cakraawijaya/Aquaponic-pH-Control-Monitoring-with-Type-2-Fuzzy-Method-Based-on-IoT-Bot/README.md

# Aquaponic pH Control-Monitoring with Type 2 Fuzzy Method-Based on IoT-Bot
<strong>Undergraduate Thesis Project Documentation - Informatics UPN Veteran Jatim</strong><br><br>
An aquaponic system is a combined farming system between fish with vegetables where the activities are mutually beneficial. On the other hand, crop failure can also be a concern for aquaponic farmers as this can happen at any time. Harvest failure can be influenced by many factors, but is usually caused by the high pH ambiguity of the water around the scope of cultivation. The aquaponic farmers are worried that if the crop failure continues it will harm their food security. This project was created in the hope of solving the pH problem. This project has been carried out and took approximately 1 year. The system created can control and monitor changes in water pH at any time. This system is based on the Internet of Things (IoT), using MQTT as the communication protocol. This system is also equipped with artificial intelligence, which uses IT2FL (Interval Type-2 Fuzzy Logic) as its decision support. In addition, the system interface uses Telegram Bot, making it easier for users to interact.

<br><br>

## Project Requirements
| Part | Description |
| --- | --- |
| Development Board | DOIT ESP32 DEVKIT V1 |
| Supporting Board | Arduino Uno R3 |
| Code Editor | Arduino IDE 1.8.19 (Stable Legacy Version) |
| Application Support | • Telegram Bot<br>• Matlab R2020 |
| Driver | CP210X USB Driver |
| IoT Platform | io-t.net |
| Communications Protocol | • Inter Integrated Circuit (I2C)<br>• Message Queuing Telemetry Transport (MQTT)<br>• MTProto |
| IoT Architecture | 3 Layer |
| Matlab |  Fuzzy Interface System |
| Programming Language | C/C++ |
| Arduino Library | • WiFi (default)<br>• PubSubClient by Nick O'Leary (Version: 2.8)<br>• LiquidCrystal_I2C by Frank de Brabander (Version: 1.1.2)<br>• CTBot by Stefano Ledda (Version: 2.1.11)<br>• ArduinoJson by Benoit Blanchon (Version: 6.19.4)<br>• RTClib by Adafruit (Version: 2.0.2) |
| Actuators | • Submersible pump aquarium (x1)<br>• Pneumatic solenoid valve (x2)<br>• Piezoelectric (x1)<br>• Electromechanical relay 2-channel (x1) |
| Sensor | • pH Sensor (x1)<br>• RTC (x1) |
| Display | LCD I2C (x1) |
| Experimental Object | • Pakcoy mustard seeds<br>• Dumbo catfish fry |
| Other Components | • Micro USB cable - USB type A (x1)<br>• Jumper cable (1 set)<br>• Switching power supply 12V 1A (x1)<br>• Round switch (x1)<br>• DOIT ESP32 DEVKIT V1 expansion board (x1)<br>• PCB Dot Matrix (x1)<br>• Terminal PCB block screw (x10)<br>• Socket female jack DC (x1)<br>• Connector male jack DC (x3)<br>• Probe Elektroda pH (x1)<br>• Pipes (1 set)<br>• Netpot (1 set)<br>• Rockwool (1 set)<br>• Flannel fabric (1 set)<br>• Water filter (x1)<br>• Glass hubcap (1 set)<br>• Bottle (x2)<br>• Aquarium wheeled placemat (x1)<br>• Aquarium (x1)<br>• Acrylic box (x1)<br>• Solenoid Valve Plastic Cover (x2)<br>• Skun (1 set)<br>• Galvanized plate (x1)<br>• Bolts plus (1 set)<br>• Nuts (1 set) |

<br><br>

## Download & Install 
1. Arduino IDE

   <table><tr><td width="810">

   ```
   https://www.arduino.cc/en/software
   ```

   </td></tr></table><br>

2. CP210X USB Driver

   <table><tr><td width="810">

   ```
   https://bit.ly/CP210X_USBdriver
   ```

   </td></tr></table><br>

3. Matlab R2020

   <table><tr><td width="810">

   ```
   https://bit.ly/MATLAB_R2020a_Installer
   ```

   </td></tr></table>

<br><br>

## Project Designs
<table>
<tr>
<th width="840">Infrastructure</th>
</tr>
<tr>
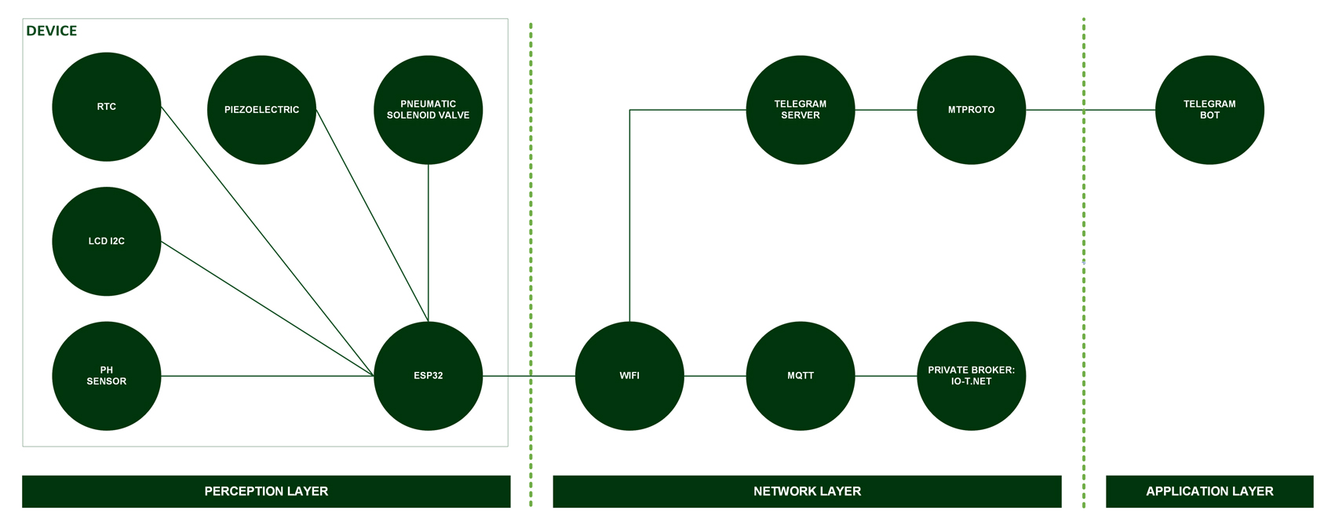
[picture p1: Assets/Documentation/Diagram/Infrastructure.jpg]
infrastructure
<td></td>
</tr>
</table>
<table>
<tr>
<th width="280">Pictorial Diagram</th>
<th width="280">Prototype Design</th>
<th width="280">Main Box Design</th>
</tr>
<tr>
<td>pictorial-diagram</td>
<td>prototype-design</td>
<td>mainBox-design</td>
</tr>
</table>
<table>
<tr>
<th width="280">Fuzzy Interface System IT2FL</th>
<th width="280">IT2FL Input Variable</th>
<th width="280">IT2FL Output Variable</th>
</tr>
<tr>
<td>fis-it2fl</td>
<td>varin-it2fl</td>
<td>varout-it2fl</td>
</tr>
</table>

<br><br>

## Scanning the I2C Address on the LCD
<table><tr><td width="840">
   
```ino
/*
  =====================================================
  I2C Scanner for Arduino / ESP32 / ESP8266
  by: Devan Cakra Mudra Wijaya, S.Kom.
  =====================================================

  Functions:
  - Detects all connected I2C devices
  - Displays device addresses in HEX format
  - Displays the total number of detected devices

  =====================================================
  SDA and SCL Pins for Arduino / ESP32 / ESP8266
  =====================================================
  Arduino I2C Connection (default):
  - Arduino Uno / Nano (ATmega328P)
    SDA -> A4
    SCL -> A5

  - Arduino Mega 2560
    SDA -> D20
    SCL -> D21

  - Other Arduino boards
    SDA -> SDA pin
    SCL -> SCL pin
    (Refer to the datasheet or board pinout)

  ESP32 I2C Connection (default):
  SDA -> GPIO 21
  SCL -> GPIO 22

  ESP8266 I2C Connection (default):
  SDA -> GPIO 4 (D2)
  SCL -> GPIO 5 (D1)
*/

// Include the Wire library for I2C communication
#include <Wire.h>

// Constant that defines the delay between scans (5000 ms = 5 seconds)
const uint32_t SCAN_INTERVAL = 5000;

// Function to initialize I2C communication
// SDA and SCL pin configuration will be adjusted automatically based on the board being used
void initI2C() {

  // If the board being used is ESP32:
  #if defined(ESP32)

    // Enable I2C communication
    // SDA = GPIO21
    // SCL = GPIO22
    Wire.begin(21, 22);

  // If the board being used is ESP8266:
  #elif defined(ESP8266)

    // Enable I2C communication
    // SDA = D2 (GPIO4)
    // SCL = D1 (GPIO5)
    Wire.begin(D2, D1);

  // If the board is neither ESP32 nor ESP8266
  // Examples: Arduino Uno, Nano, Mega, Leonardo, etc.
  #else

    // Enable I2C communication using the board's built-in hardware pins
    Wire.begin();

  #endif

}

// The setup() function runs once when the board is powered on or reset
// It is used to initialize hardware, serial communication, sensors, modules, and the program's initial configuration
void setup() {

  // Start Serial communication at 115200 baud rate
  Serial.begin(115200);

  // Check whether the board uses native USB
  // Examples: Arduino Leonardo, Arduino Micro, some ESP32-S2/S3 boards
  #if defined(USBCON) || defined(ARDUINO_USB_CDC_ON_BOOT)

    // If yes:
    // The program will wait until the Serial Monitor is connected before continuing execution
    while (!Serial);

  #endif

  // Wait for 2 seconds before starting the program
  delay(2000);

  // Display program header
  Serial.println("====================================");
  Serial.println("         I2C DEVICE SCANNER         ");
  Serial.println("by: Devan Cakra Mudra Wijaya, S.Kom.");
  Serial.println("====================================");

  // Print an empty line
  Serial.println();

  // Initialize I2C communication
  initI2C();
}

// The loop() function runs continuously after setup() has finished
// The main program logic is typically placed inside this function
void loop() {

  // Variable to store the error code returned from I2C communication
  uint8_t error;

  // Variable to store the I2C address currently being checked
  uint8_t address;

  // Counter variable for the number of detected devices
  uint8_t deviceCount = 0;

  // Display information indicating that the scan process has started
  Serial.println("------------------------------------");
  Serial.println("Scanning I2C bus...");
  Serial.println("------------------------------------");

  // Loop through addresses from 1 to 126
  // Valid I2C addresses range from 0x01 to 0x7E
  for (address = 1; address < 127; address++) {

    // Start communication with the address currently being tested
    Wire.beginTransmission(address);

    // End the transmission and store the result
    // 0 = success
    // 1 = data too long
    // 2 = NACK received when address was sent
    // 3 = NACK received when data was sent
    // 4 = other error
    error = Wire.endTransmission();

    // If no error occurs:
    if (error == 0) {

      // Display information that a device was found
      Serial.print("[FOUND] Device at address 0x");

      // If the address is less than 16:
      // Add a leading zero to keep HEX formatting aligned
      if (address < 16) {
        Serial.print("0");
      }

      // Display the address in HEX format
      Serial.println(address, HEX);

      // Increment the detected device count
      deviceCount++;
    }

    // If an unknown error occurs:
    else if (error == 4) {

      // Display an error message
      Serial.print("[ERROR] Unknown error at address 0x");

      // If the address is less than 16:
      // Add a leading zero to keep HEX formatting aligned
      if (address < 16) {
        Serial.print("0");
      }

      // Display the problematic address in HEX format
      Serial.println(address, HEX);
    }

    // If the error is neither 0 nor 4:
    // Ignore it, as this usually means no device exists at that address
  }

  // Print an empty line
  Serial.println();

  // If no devices were found:
  if (deviceCount == 0) {

    // Display a message indicating that no devices were found
    Serial.println("No I2C devices found.");
  }
  else { // If at least one device was found:

    // Display the total number of detected devices
    Serial.print("Total devices found: ");

    // Display the value of deviceCount
    Serial.println(deviceCount);
  }

  // Display information about the next scan
  Serial.print("Next scan in ");

  // Convert milliseconds to seconds
  Serial.print(SCAN_INTERVAL / 1000);

  // Display the unit in seconds
  Serial.println(" seconds.");

  // Empty line
  Serial.println("\n");

  // Wait 5 seconds before performing the next scan
  delay(SCAN_INTERVAL);
}
```

</td></tr></table><br><br>

##  pH Sensor Calibration
The pH sensor can be calibrated using the results of a linear regression calculation. You can see the linear regression equation as follows.

<table>
   <tr>
   <td width="40">I</td>
   <td width="800" height="80">

   $\ Y = a+b.X $
         
   </td>      
   </tr>
</table><br>

Explanation of the symbols in equation I, you can see more details in the following table.

<table>
   <tr height="50px">
      <th width="120">Symbol</th>
      <th width="720">Description</th>
   </tr>
   <tr>
      <td>𝑌</td>
      <td>pH buffer value</td>
   </tr>
   <tr>
      <td>𝑋</td>
      <td>voltage value obtained based on Y</td>
   </tr>
   <tr>
      <td>𝑎 and 𝑏</td>
      <td>linear regression determination value</td>
   </tr>
</table><br>

The linear regression determination values (a and b) can be obtained through equations II and III.

<table>
   <tr>
   <td width="40">II</td>
   <td width="800" height="80">
   
   $\ a = \frac{\sum Y.\sum X^{2}-\sum X.\sum XY}{n.\sum X^{2}-(\sum X)^{2}} $

   </td>
   </tr>
   <tr>
   <td width="40">III</td>
   <td width="800" height="80">
   
   $\ b = \frac{n.\sum XY-\sum X.\sum Y}{n.\sum X^{2}-(\sum X)^{2}} $

   </td>
   </tr>
</table><br>

Example of pH sensor calibration: <a href="https://github.com/devancakra/Aquaponic-pH-Control-Monitoring-with-Type-2-Fuzzy-Method-Based-on-IoT-Bot/blob/master/Assets/Articles/pHSensor-Calibration-Example.md">Click Here</a>

<br><br>

## RTC Sensor Calibration
This RTC sensor can be calibrated using the following program code :
   
<table><tr><td width="840">

```ino
#include <RTClib.h> // Calling the RTC library
RTC_DS3231 rtc; // Constructor

void setup() {
   RTCinit(); // Calling the RTCinit method
}

void loop() {}

void RTCinit() {
   // Starting up the RTC
   rtc.begin();

   // Set Time Now
   // If calibrated, please close with a comment
   rtc.adjust(DateTime(YYYY, MM, DD, HH, MM, SS));
}
```

</td></tr></table><br><br>

## Arduino IDE Setup
1. Open the ``` Arduino IDE ``` first, then open the project by clicking ``` File ``` -> ``` Open ``` : 

   <table><tr><td width="810">
   
      ``` PH_IT2FL.ino ```

   </td></tr></table><br>
   
2. Fill in the ``` Additional Board Manager URLs ``` in Arduino IDE

   <table><tr><td width="810">
      
      Click ``` File ``` -> ``` Preferences ``` -> enter the ``` Boards Manager Url ``` by copying the following link :
      
      ```
      https://dl.espressif.com/dl/package_esp32_index.json
      ```

   </td></tr></table><br>
   
3. ``` Board Setup ``` in Arduino IDE

   <table>
      <tr><th width="810">

      How to setup the ``` DOIT ESP32 DEVKIT V1 ``` board
            
      </th></tr>
      <tr><td width="810">
      
      • Click ``` Tools ``` -> ``` Board ``` -> ``` Boards Manager ``` -> Install ``` esp32 ```. 
      
      • Then selecting a Board by clicking: ``` Tools ``` -> ``` Board ``` -> ``` ESP32 Arduino ``` -> ``` DOIT ESP32 DEVKIT V1 ```.

      • ``` Arduino Uno ``` board in this project is only used as a filter or voltage divider.

      • You don't need to configure the ``` Arduino Uno ``` board, just focus on the ``` ESP32 ```.

   </td></tr></table><br>
   
4. ``` Change the Board Speed ``` in Arduino IDE

   <table><tr><td width="810">
      
      Click ``` Tools ``` -> ``` Upload Speed ``` -> ``` 9600 ```

   </td></tr></table><br>
   
5. ``` Install Library ``` in Arduino IDE

   <table><tr><td width="810">
      
      Download all the library zip files. Then paste it in the: ``` C:\Users\Computer_Username\Documents\Arduino\libraries ```

   </td></tr></table><br>

6. ``` Port Setup ``` in Arduino IDE

   <table><tr><td width="810">
      
      Click ``` Port ``` -> Choose according to your device port ``` (you can see in device manager) ```

   </td></tr></table><br>

7. Change the ``` WiFi Name ```, ``` WiFi Password ```, and so on according to what you are currently using.<br><br>

8. Before uploading the program, please click: ``` Verify ```.<br><br>

9. If there is no error in the program code, then please click: ``` Upload ```.<br><br>
    
10. Some things you need to do when using the ``` ESP32 board ``` :

    <table><tr><td width="810">
       
       • If ``` ESP32 board ``` cannot process ``` Source Code ``` totally -> Press ``` EN (RST) ``` button -> ``` Restart ```.

       • If ``` ESP32 board ``` cannot process ``` Source Code ``` automatically then :<br>

      - When information: ``` Uploading... ``` has appeared -> immediately press and hold the ``` BOOT ``` button.<br>

      - When information: ``` Writing at .... (%) ``` has appeared -> release the ``` BOOT ``` button.

      • If message: ``` Done Uploading ``` has appeared -> ``` The previously entered program can already be operated ```.

      • Do not press the ``` BOOT ``` and ``` EN ``` buttons at the same time as this may switch to ``` Upload Firmware ``` mode.

    </td></tr></table><br>

11. If there is still a problem when uploading the program, then try checking the ``` driver ``` / ``` port ``` / ``` others ``` section.

<br><br>

## Io-t.net Setup
1. Getting started with io-t.net :

   <table><tr><td width="810">
      
      • Go to the official website at the following link : <a href="https://io-t.net/">io-t.net</a>.
      
      • If you do not have an account, please <a href="https://i-ot.net/register">Register</a> first -> activate your account via email.
      
      • If you already have an account, please <a href="https://i-ot.net/login">Sign In</a> to be able to access io-t.net services.

   </td></tr></table><br>

2. Create a node :

   <table><tr><td width="810">
      
      • Go to ``` Instance ``` menu -> ``` Set Node ```.
      
      • Then give the node a unique name that you use.

   </td></tr></table><br>

3. Create a device :

   <table><tr><td width="810">
      
      • Go to ``` Devices ``` menu.
      
      • Select ``` Add Devices ``` -> fill in the ``` Client ID ```, ``` Access ```, ``` Topic ``` sections as needed. For example :
   
      - ``` Client ID ``` -> ``` Phiotnet_v1 ```.

      - ``` Access ``` -> ``` Publish & Subscribe ```.

      - ``` Topic ``` -> ``` detect ```.

   </td></tr></table>
   
<br><br>

## Telegram Bot Setup
1. Open <a href="https://t.me/botfather">@BotFather</a>.<br><br>

2. Type ``` /newbot ```.<br><br>

3. Type the desired bot name, for example: ``` phiotnet_bot ```.<br><br>

4. Type the desired bot username, for example: ``` phiotnet_bot ```.<br><br>

5. Also do it for bot image settings, bot descriptions, and so on according to your needs.<br><br>

6. Copy ``` your telegram bot API token ``` -> then paste it into the ``` #define BOTtoken "YOUR_API_BOT_TOKEN" ``` section. 

   <table><tr><td width="810">
   For example :<br><br>

   ```ino
   #define BOTtoken "2006772150:AAE6Fdjk3KbiySkzV6CLbd6ClJDzgTfJ5y0"
   ```
   
   </td></tr></table>

<br><br>

## Matlab Setup
1. Open the ``` Matlab ```.<br><br>

2. Open the ``` Set Path ``` dialog box using the command :
   
   <table><tr><td width="810">
      
   ```
   pathtool
   ```

   </td></tr></table>
   
   set-path-matlab<br><br>

3. Select ``` Add Folder... ``` -> search the ``` FIS-IT2FLS-Toolbox-MATLAB ``` folder -> ``` Select Folder ```.<br><br>

4. Click ``` Save ``` and then click ``` Close ```.<br><br>

5. Open the ``` IT2FL Toolbox ``` using the command :
   
   <table><tr><td width="810">

   ```
   fuzzyt2
   ```

   </td></tr></table>
   
   it2fl-toolbox<br><br>

6. The rest you can customize according to your needs.

<br><br>

## Get Started
1. Download and extract this repository.<br><br>
   
2. Make sure you have the necessary electronic components.<br><br>
   
3. Make sure your components are designed according to the diagram.<br><br>
   
4. Configure your device according to the settings above.<br><br>

5. Please enjoy [Done].

<br><br>

## Demonstration of Application
Via Telegram: <a href="https://t.me/phiotnet_bot">@phiotnet_bot</a>

<br><br>

## Highlights
<table>
<tr>
<th width="840">Product</th>
</tr>
<tr>
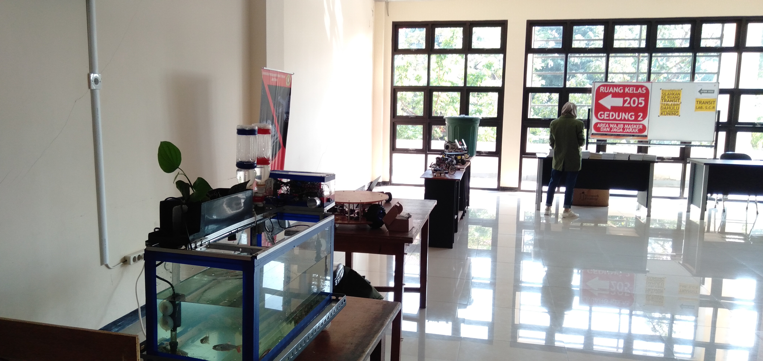
[picture p2: Assets/Documentation/Experiment/Product/Exhibition.jpg]
exhibition
<td></td>
</tr>
<tr>
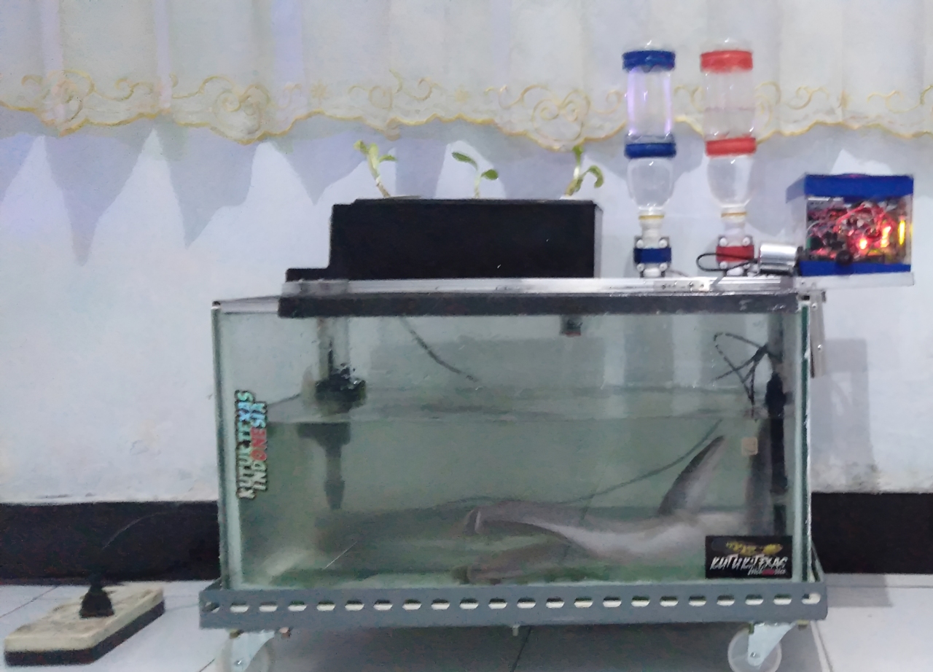
[picture p3: Assets/Documentation/Experiment/Product/Device ON.jpg]
device-on
<td></td>
</tr>
</table>
<table>
<tr>
<th width="840" colspan="6">LCD Screen</th>
</tr>
<tr>
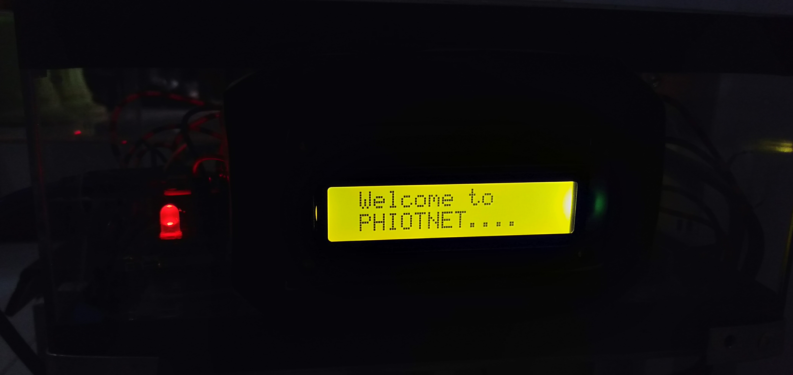
[picture p4: Assets/Documentation/Experiment/LCD/Welcome to PHIOTNET.jpg]
welcome-to-phiotnet
<td></td>
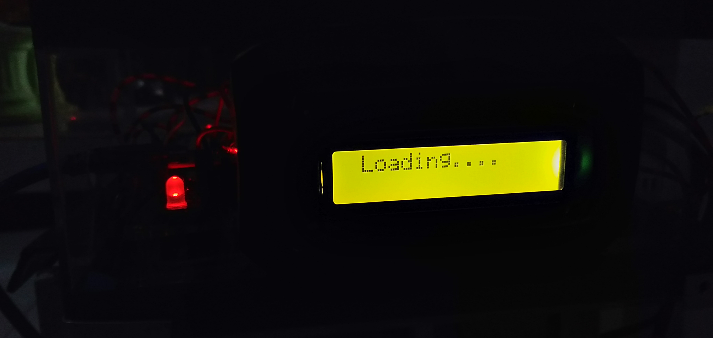
[picture p5: Assets/Documentation/Experiment/LCD/Loading.jpg]
loading
<td></td>
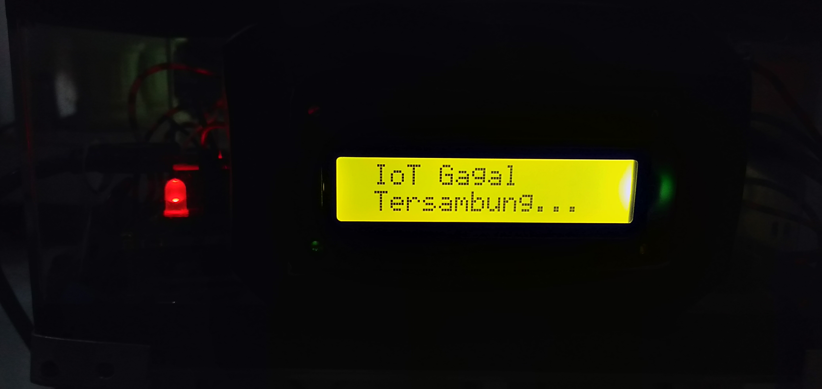
[picture p6: Assets/Documentation/Experiment/LCD/IoT Connection Failed.jpg]
iot-connection-failed
<td></td>
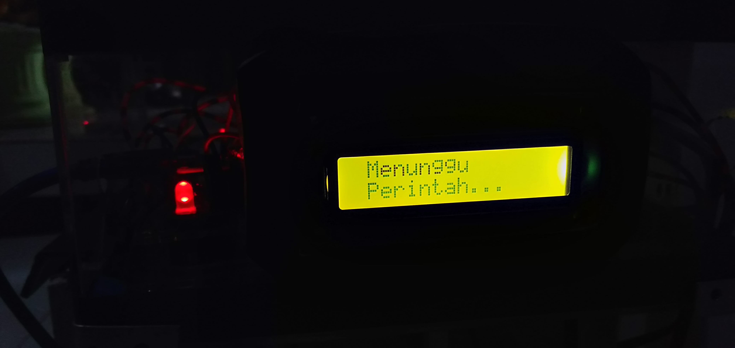
[picture p7: Assets/Documentation/Experiment/LCD/Waiting for Instructions.jpg]
waiting-for-instructions
<td></td>
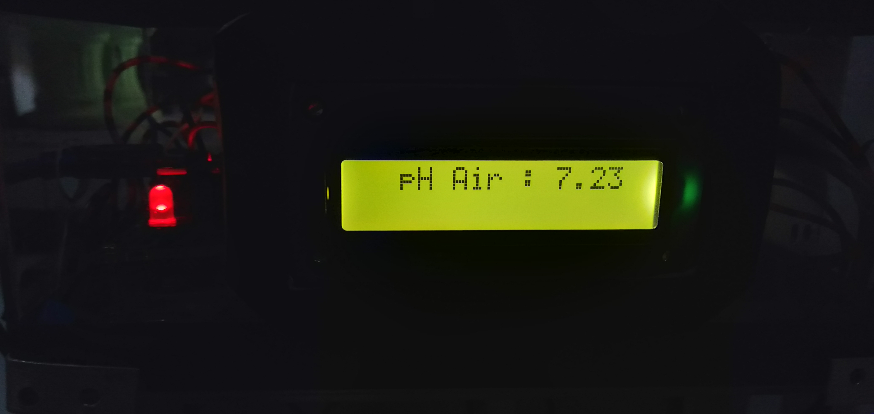
[picture p8: Assets/Documentation/Experiment/LCD/pH Value of Water.jpg]
ph-value-of-water
<td></td>
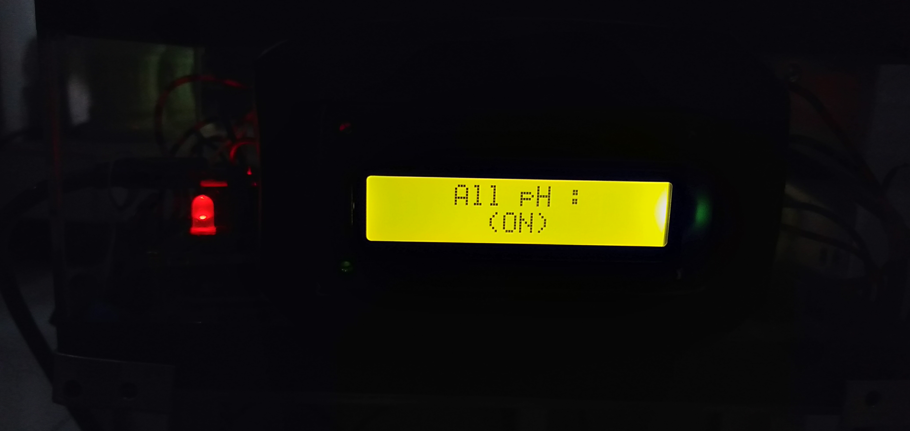
[picture p9: Assets/Documentation/Experiment/LCD/All pH ON.jpg]
all-pH-on
<td></td>
</tr>
<tr>
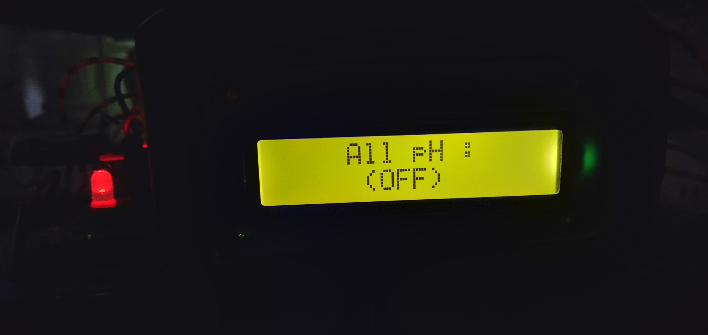
[picture p10: Assets/Documentation/Experiment/LCD/All pH OFF.jpg]
all-pH-off
<td></td>
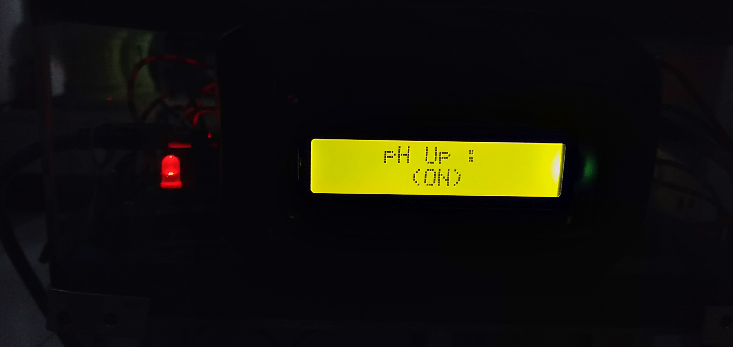
[picture p11: Assets/Documentation/Experiment/LCD/pH Up ON.jpg]
pH-up-on
<td></td>
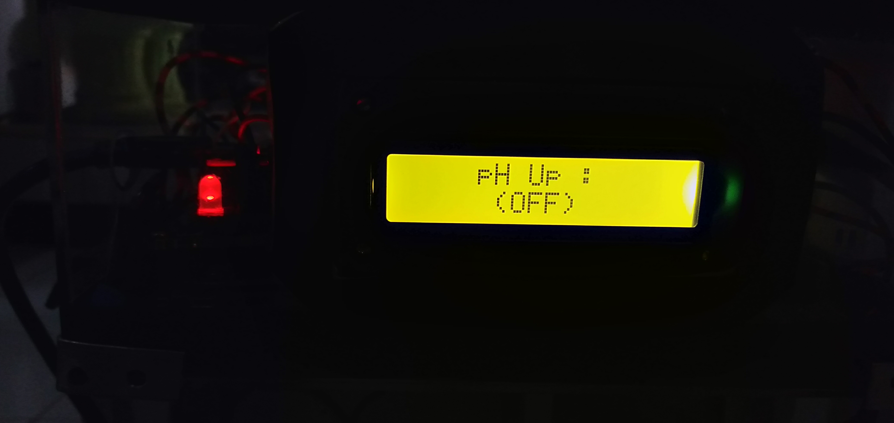
[picture p12: Assets/Documentation/Experiment/LCD/pH Up OFF.jpg]
pH-up-off
<td></td>
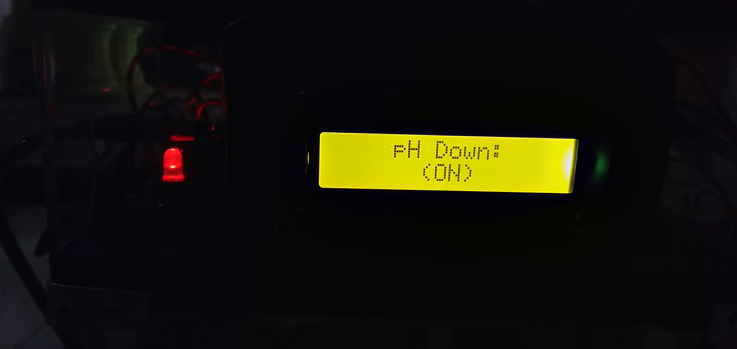
[picture p13: Assets/Documentation/Experiment/LCD/pH Down ON.jpg]
pH-down-on
<td></td>
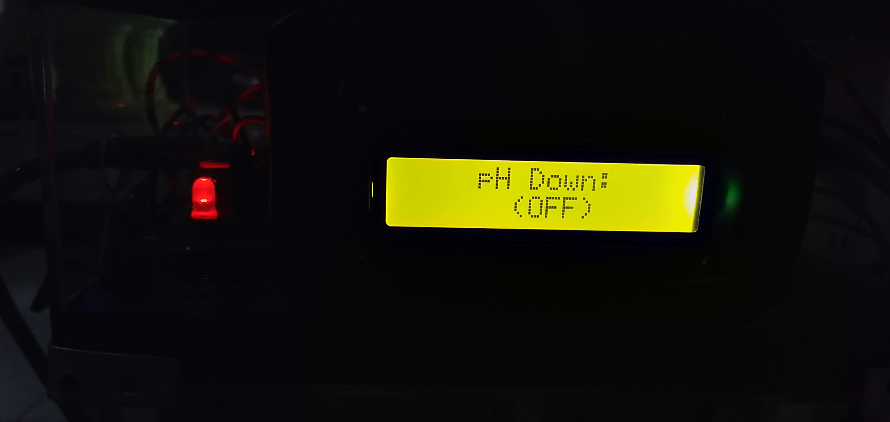
[picture p14: Assets/Documentation/Experiment/LCD/pH Down OFF.jpg]
pH-down-off
<td></td>
</tr>
</table>
<table>
<tr>
<th width="840" colspan="5">IT2FL Decision Support System</th>
</tr>
<tr>
<th width="168">Strong Acids</th>
<th width="168">Weak Acids</th>
<th width="168">Neutral</th>
<th width="168">Weak Bases</th>
<th width="168">Strong Bases</th>
</tr>
<tr>
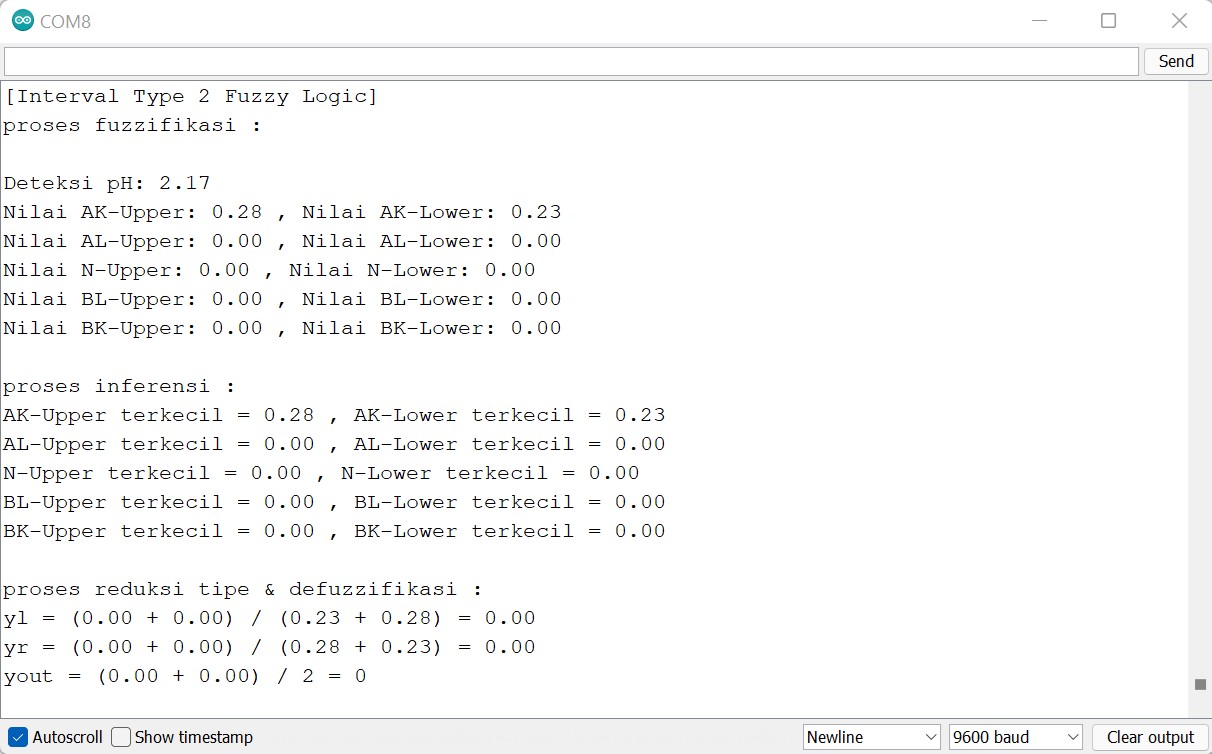
[picture p15: Assets/Documentation/Experiment/Serial Monitor/IT2FL Decision Support System/Strong Acids.jpg]
strong-acids
<td align="center"></td>
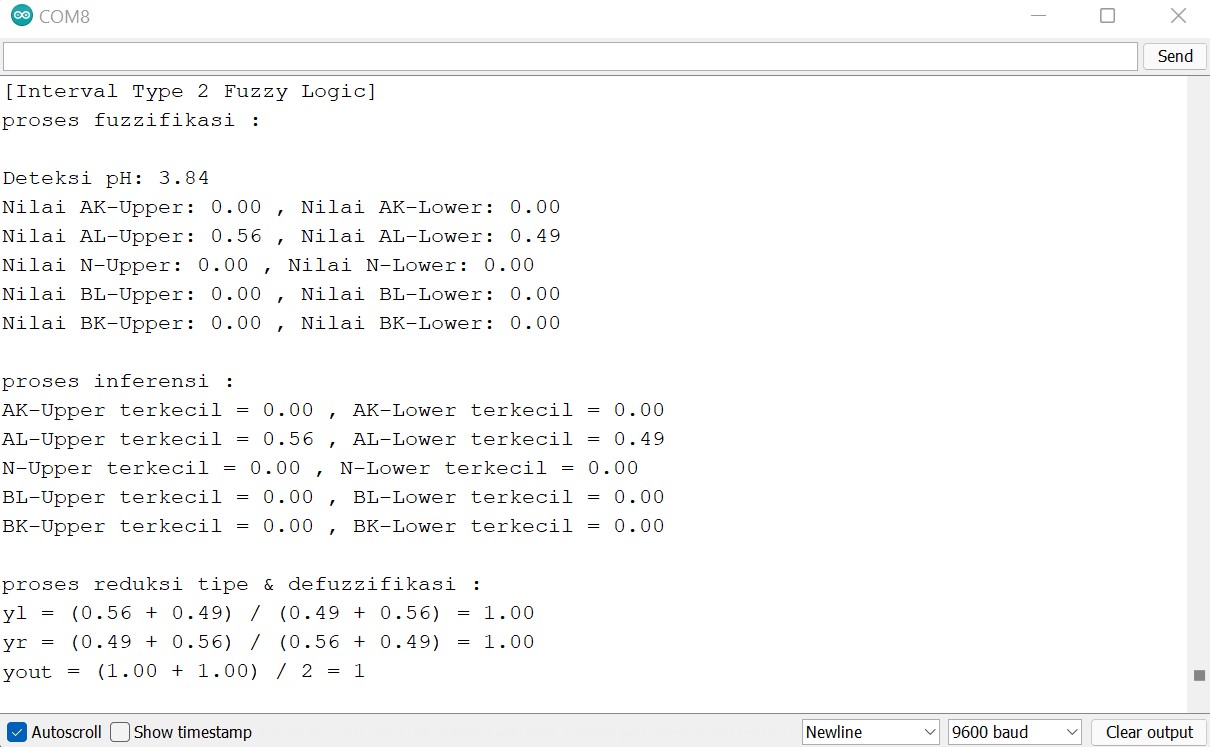
[picture p16: Assets/Documentation/Experiment/Serial Monitor/IT2FL Decision Support System/Weak Acids.jpg]
weak-acids
<td align="center"></td>
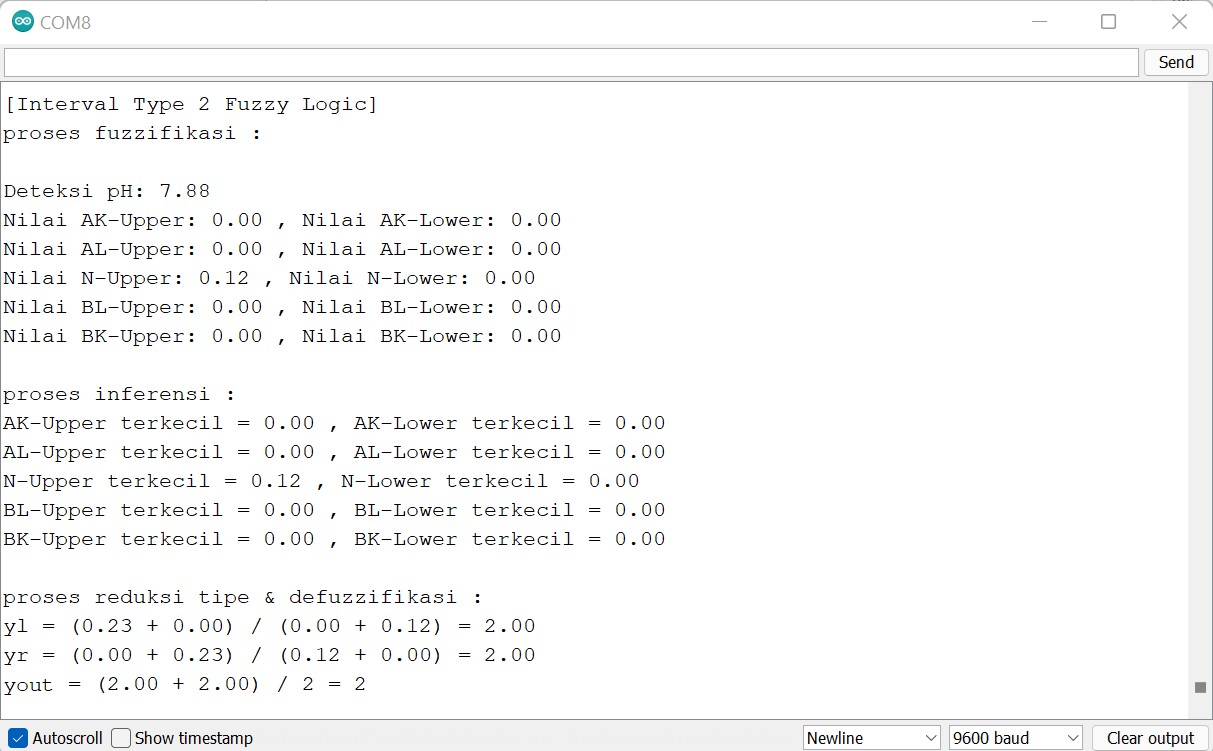
[picture p17: Assets/Documentation/Experiment/Serial Monitor/IT2FL Decision Support System/Neutral.jpg]
neutral
<td align="center"></td>
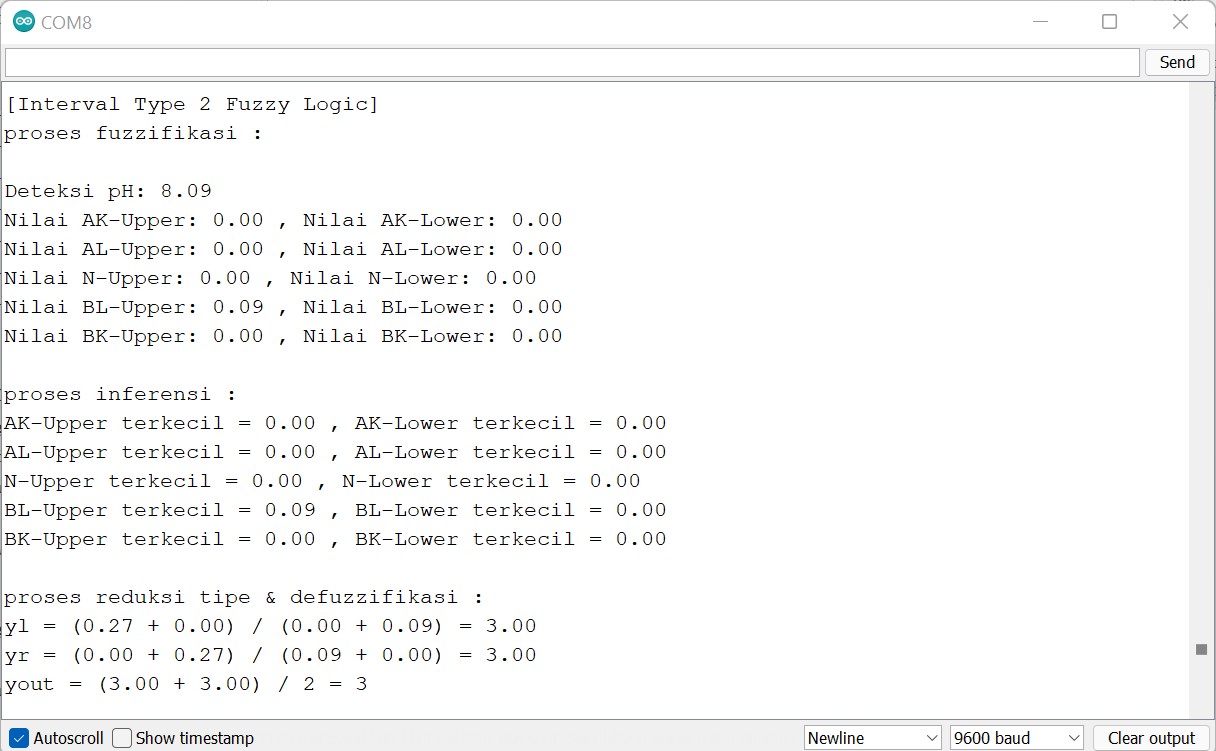
[picture p18: Assets/Documentation/Experiment/Serial Monitor/IT2FL Decision Support System/Weak Bases.jpg]
weak-bases
<td align="center"></td>
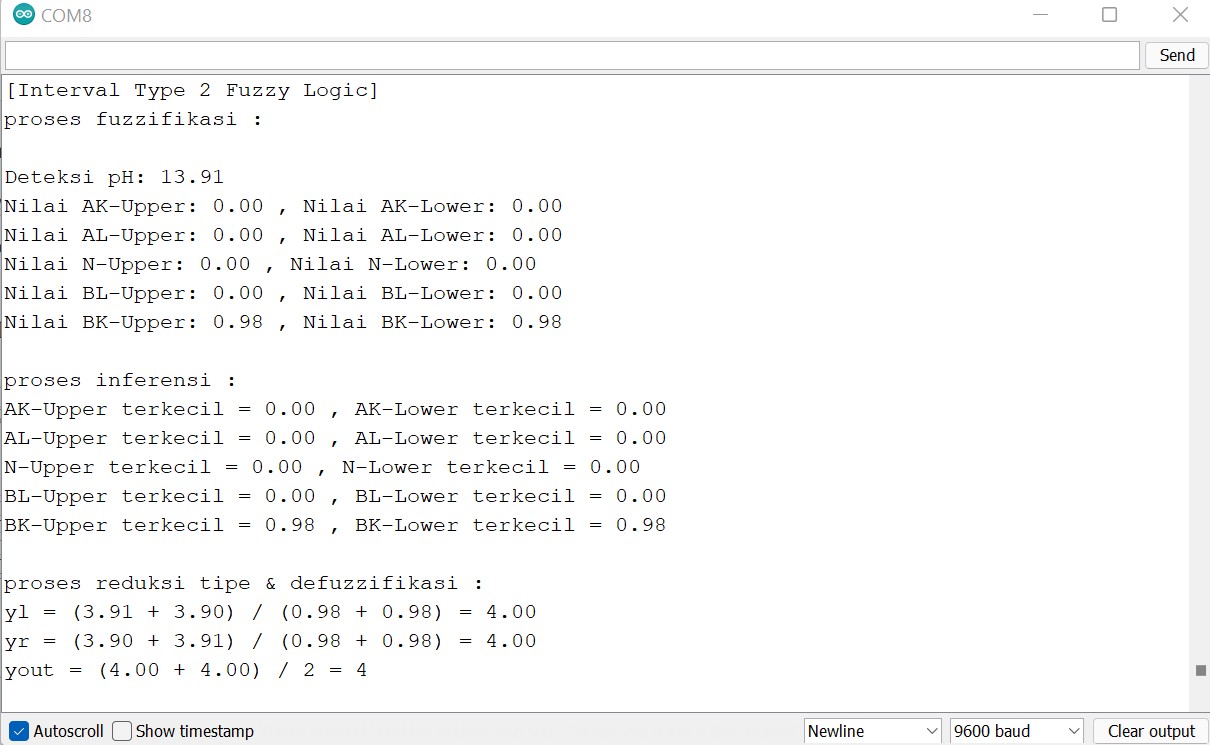
[picture p19: Assets/Documentation/Experiment/Serial Monitor/IT2FL Decision Support System/Strong Bases.jpg]
strong-bases
<td align="center"></td>
</table>
<table>
<tr>
<th width="840" colspan="6">Telegram Bot</th>
</tr>
<tr>
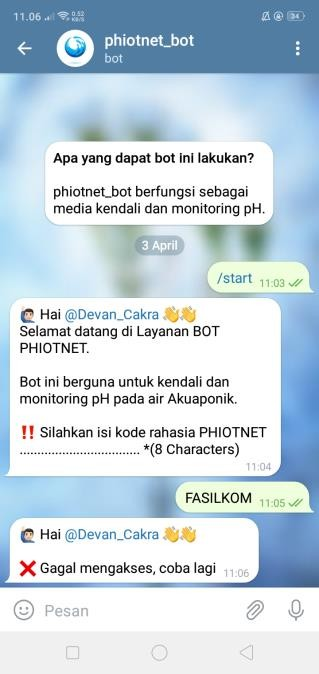
[picture p20: Assets/Documentation/Experiment/Telegram Bot/Access Denied.jpg]
access-denied
<td align="center"></td>
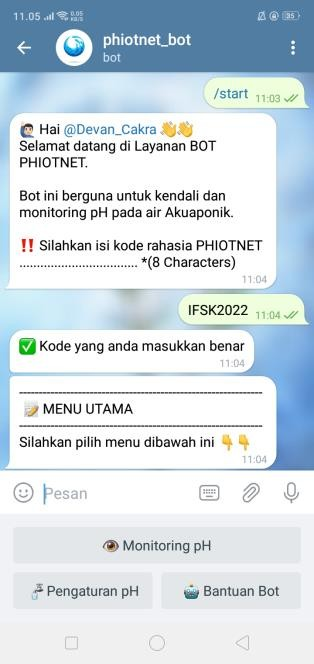
[picture p21: Assets/Documentation/Experiment/Telegram Bot/Main Menu.jpg]
main-menu
<td align="center"></td>
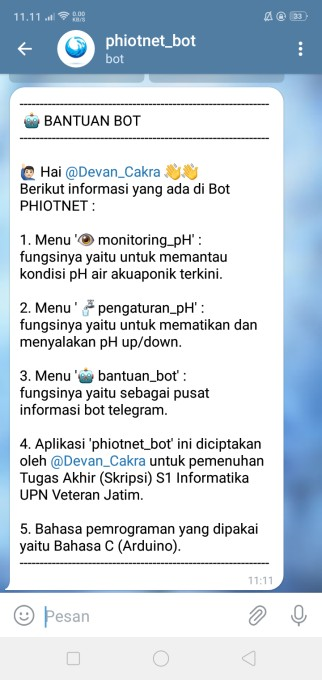
[picture p22: Assets/Documentation/Experiment/Telegram Bot/Bot Help.jpg]
bot-help
<td align="center"></td>
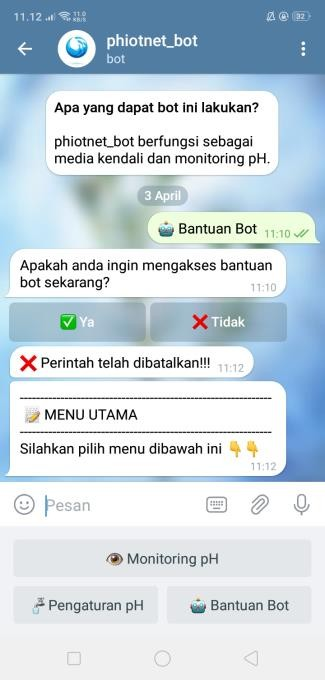
[picture p23: Assets/Documentation/Experiment/Telegram Bot/Bot Help (Canceled).jpg]
bot-help-canceled
<td align="center"></td>
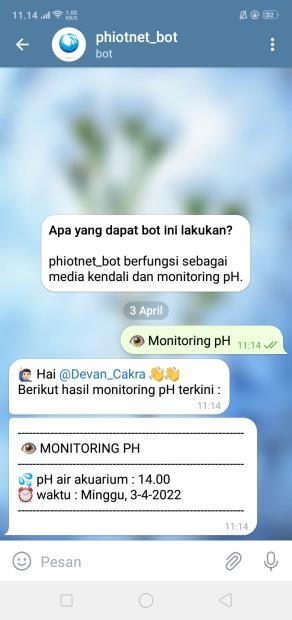
[picture p24: Assets/Documentation/Experiment/Telegram Bot/Monitoring pH.jpg]
monitoring-ph
<td align="center"></td>
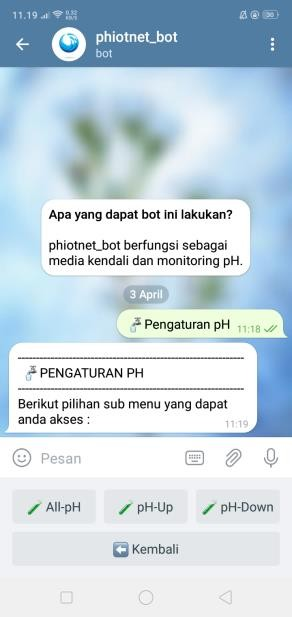
[picture p25: Assets/Documentation/Experiment/Telegram Bot/pH Adjustment Menu.jpg]
ph-adjustment-menu
<td align="center"></td>
</tr>
<tr>
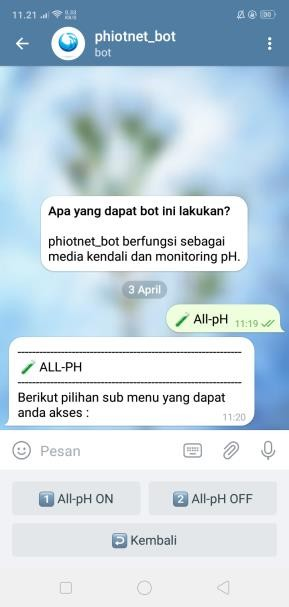
[picture p26: Assets/Documentation/Experiment/Telegram Bot/All pH Menu.jpg]
all-ph-menu
<td align="center"></td>
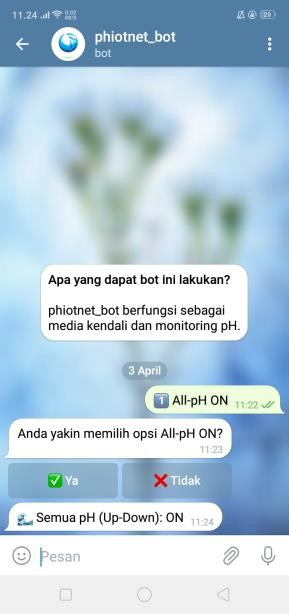
[picture p27: Assets/Documentation/Experiment/Telegram Bot/All pH ON (Applied).jpg]
all-ph-on-applied
<td align="center"></td>
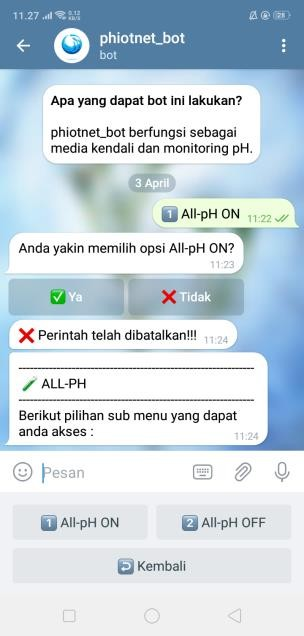
[picture p28: Assets/Documentation/Experiment/Telegram Bot/All pH ON (Canceled).jpg]
all-ph-on-canceled
<td align="center"></td>
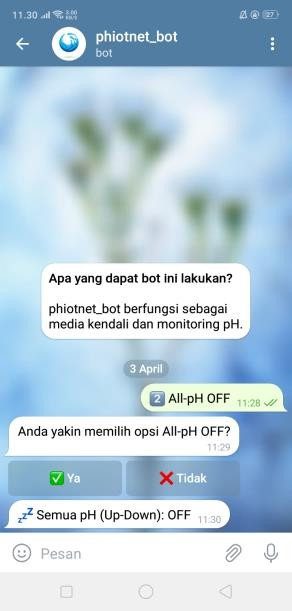
[picture p29: Assets/Documentation/Experiment/Telegram Bot/All pH OFF (Applied).jpg]
all-ph-off-applied
<td align="center"></td>
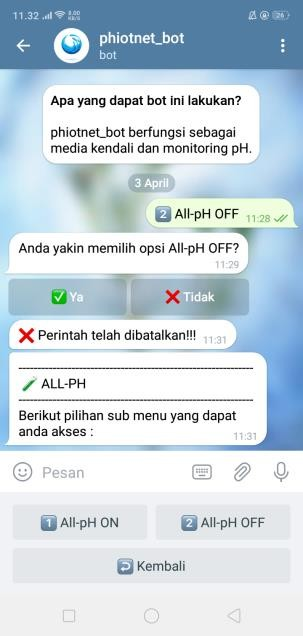
[picture p30: Assets/Documentation/Experiment/Telegram Bot/All pH OFF (Canceled).jpg]
all-ph-off-canceled
<td align="center"></td>
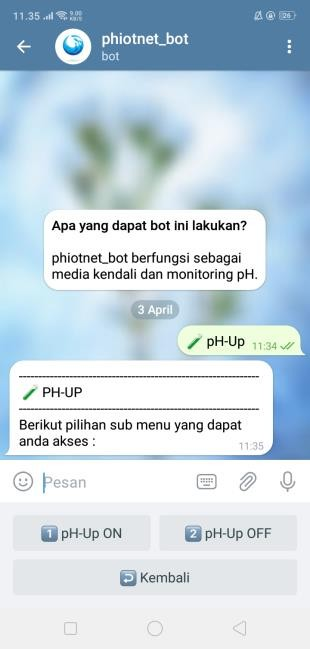
[picture p31: Assets/Documentation/Experiment/Telegram Bot/pH Up Menu.jpg]
ph-up-menu
<td align="center"></td>
</tr>
<tr>
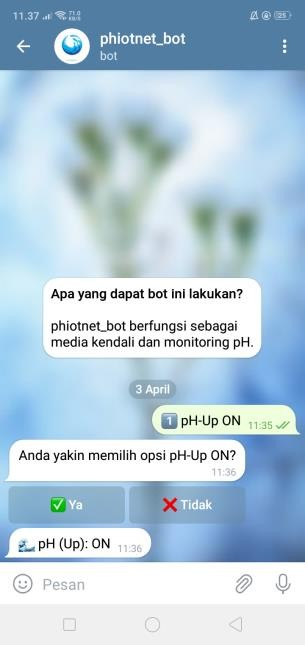
[picture p32: Assets/Documentation/Experiment/Telegram Bot/pH Up ON (Applied).jpg]
ph-up-on-applied
<td align="center"></td>
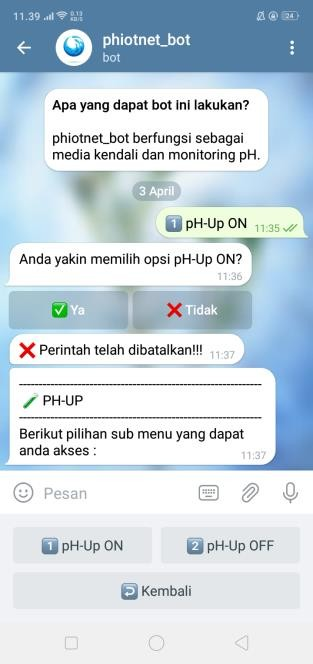
[picture p33: Assets/Documentation/Experiment/Telegram Bot/pH Up ON (Canceled).jpg]
ph-up-on-canceled
<td align="center"></td>
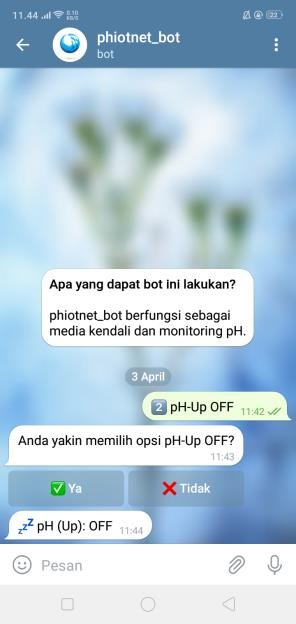
[picture p34: Assets/Documentation/Experiment/Telegram Bot/pH Up OFF (Applied).jpg]
ph-up-off-applied
<td align="center"></td>
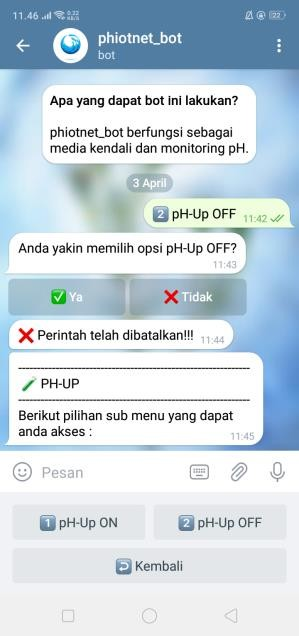
[picture p35: Assets/Documentation/Experiment/Telegram Bot/pH Up OFF (Canceled).jpg]
ph-up-off-canceled
<td align="center"></td>
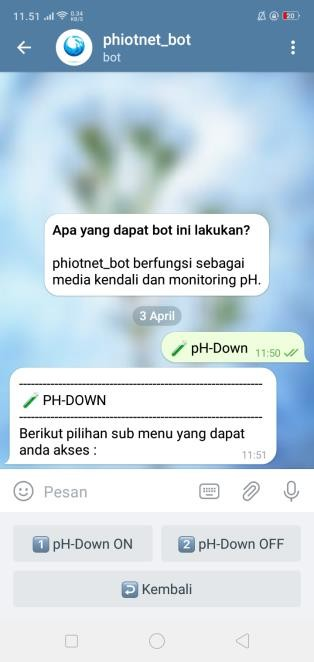
[picture p36: Assets/Documentation/Experiment/Telegram Bot/pH Down Menu.jpg]
ph-down-menu
<td align="center"></td>
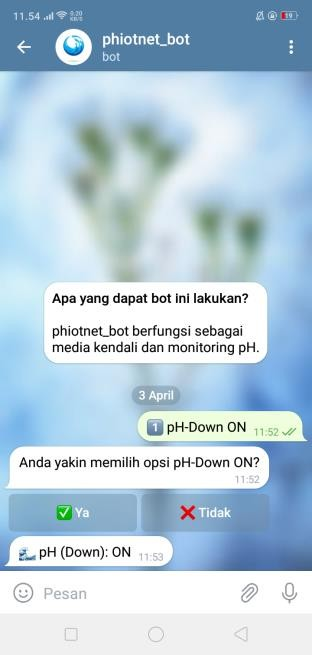
[picture p37: Assets/Documentation/Experiment/Telegram Bot/pH Down ON (Applied).jpg]
ph-down-on-applied
<td align="center"></td>
</tr>
<tr>
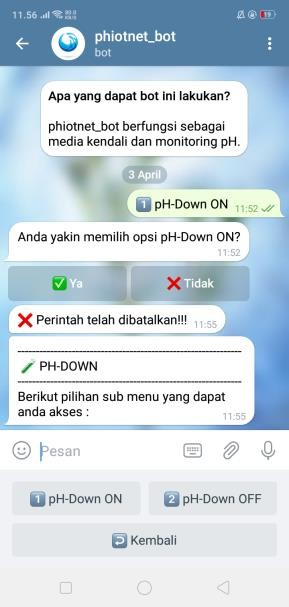
[picture p38: Assets/Documentation/Experiment/Telegram Bot/pH Down ON (Canceled).jpg]
ph-down-on-canceled
<td align="center" colspan="2"></td>
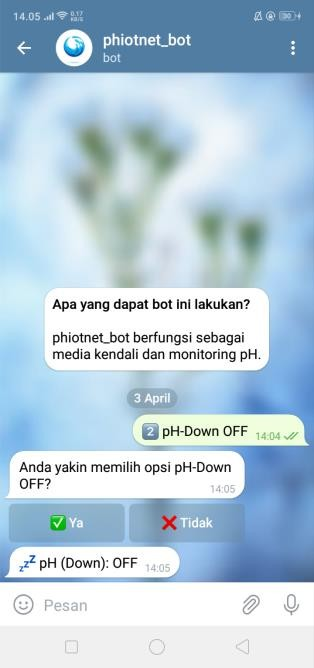
[picture p39: Assets/Documentation/Experiment/Telegram Bot/pH Down OFF (Applied).jpg]
ph-down-off-applied
<td align="center" colspan="2"></td>
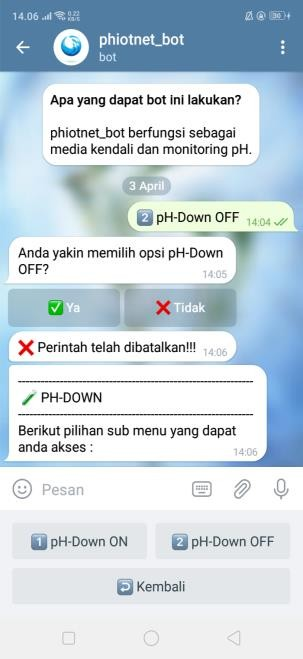
[picture p40: Assets/Documentation/Experiment/Telegram Bot/pH Down OFF (Canceled).jpg]
ph-down-off-canceled
<td align="center" colspan="2"></td>
</tr>
</table>

<br><br>
<strong>More information:</strong><br>
<table><tr><td width="840">
   • Undergraduate Thesis : <a href="http://repository.upnjatim.ac.id/id/eprint/7014"><u>Access 1</u></a> or <a href="https://www.academia.edu/127498955"><u>Access 2</u></a><br><br>
   • Journals : <a href="https://publikasi.mercubuana.ac.id/index.php/Incomtech/article/view/15453"><u>Article 1</u></a> or <a href="https://www.researchgate.net/publication/363660330"><u>Article 2</u></a>
</td></tr></table>

<br><br>

##  Notes
<ul>
<li>
   <strong><p>Hardware Repairs Suggestions :</p></strong>      
   <table>
   <tr>
   <td width="20">1.</td>
   <td width="820">The power supply in the microcontroller and actuator circuit needs to be reset separately so that the system can function properly and safely.</td>
   </tr>
   <tr>
   <td width="20">2.</td>
   <td width="820">
      Use a standard PSU with a capacity of 3A to supply multiple attached devices, such as actuators.</td>
   </tr>
   <tr>
   <td width="20">3.</td>
   <td width="820">Add a Step Down Converter to get a more stable voltage and in accordance with the needs of the device. With this component, there is no need for an Arduino Uno.</td>
   </tr>
   <tr>
   <td width="20">4.</td>
   <td width="820">Change the Electromechanical relay 2-channel setting from NO (Normally Open) to NC (Normally Close) to reduce overheating.</td>
   </tr>
   <tr>
   <td width="20">5.</td>
   <td width="820">Add insulators to electrical components to prevent leakage current.</td>
   </tr>
   <tr>
   <td width="20">6.</td>
   <td width="820">Add fans or vents to increase airflow and prevent overheating.</td>
   </tr>
   <tr>
   <td width="20">7.</td>
   <td width="820">Add Heat Sinks to heat-prone components.</td>
   </tr>
   <tr>
   <td width="20">8.</td>
   <td width="820">Add an MCB (Miniature Circuit Breaker) to prevent overcurrent, keeping the device safe and secure.</td>
   </tr>
   <tr>
   <td width="20">9.</td>
   <td width="820">Add a special case to protect the pH Sensor Probe from damage, especially from impact.</td>
   </tr>
   <tr>
   <td width="20">10.</td>
   <td width="820">Consider choosing more than 1 Development Board to improve system optimization.</td>
   </tr>
   <tr>
   <td width="20">11.</td>
   <td width="820">Consider replacing the 2-Channel Electromechanical Relay with the SSR DD Relay for smoother control (no noise), faster response, lower power consumption, higher efficiency, and better durability for long-term use.</td>
   </tr>
   <tr>
   <td width="20">12.</td>
   <td width="820">Consider replacing the acrylic box with a standard panel box to make the device much more secure and presentable.</td>
   </tr>
   <tr>
   <td width="20">13.</td>
   <td width="820">Consider replacing the cables according to the standard of use. For DC electricity, use AVS 1 x 0.5mm² cables, which are more durable than ribbon cables. Meanwhile, for AC electricity, use NYY-HY 2 x 1.5mm² cables, which are more resistant to water, weather, and physical disturbances such as rat bites.</td>
   </tr>
   </table>
</li><br>
<li>
   <strong><p>Firmware Repairs Suggestions :</p></strong>
   <table>
   <tr>
   <td width="20">1.</td>
   <td width="820">Optimize the algorithm to reduce latency in the decision-making process. It is recommended to use RTOS (Real-Time Operating System) in order to better prioritize the functions.</td>
   </tr>
   <tr>
   <td width="20">2.</td>
   <td width="820">Add OTA (Over The Air) methods to improve network security, including Telegram Bot.</td>
   </tr>
   <tr>
   <td width="20">3.</td>
   <td width="820">Add EEPROM to permanently store the pH sensor calibration results, so that the calibration does not need to be written in the loop() method again. This can save time and improve device efficiency.</td>
   </tr>
   <tr>
   <td width="20">4.</td>
   <td width="820">Add the ArduLite library and use its syntax to lighten the load of the ESP32, as it can reduce the memory usage of the ESP32. This ArduLite is ideal for projects with limited resources that prioritize efficiency and simplicity. Link: https://github.com/ArduLite/ArduLite.</td>
   </tr>
   </table>
</li><br>
<li>
   <strong><p>Automation Feature Improvement Suggestions :</p></strong>
   <table>
   <tr>
   <td width="20">1.</td>
   <td width="820">Automatic pump integrated with a level sensor to control liquid filling in the form of pH and AB Mix.</td>
   </tr>
   <tr>
   <td width="20">2.</td>
   <td width="820">Time-based automatic feeding for scheduled feeding.</td>
   </tr>
   <tr>
   <td width="20">3.</td>
   <td width="820">Automatic pump controlled via telegram bot to simplify the process of draining and replenishing water.</td>
   </tr>
   <tr>
   <td width="20">4.</td>
   <td width="820">Monitoring water quality in ponds or aquariums using a combination of pH, water temperature, and ammonia sensors.</td>
   </tr>
   <tr>
   <td width="20">5.</td>
   <td width="820">Plant irradiation with growth lamps to grow plants optimally even in low light conditions (as a substitute for sunlight).</td>
   </tr>
   </table>
</li><br>
<li>
   <strong><p>Planting Media Optimization Suggestions :</p></strong>
   <table>
   <tr>
   <td width="20">1.</td>
   <td width="820">Increase the number of hydroponic modules to accommodate more plants.</td>
   </tr>
   <tr>
   <td width="20">2.</td>
   <td width="820">Exploration of alternative growing media such as husk charcoal or cocopeat to improve plant growth efficiency.</td>
   </tr>
   </table>
</li>
</ul>

<br><br>

## Appreciation
If this work is useful to you, then support this work as a form of appreciation to the author by clicking the ``` ⭐Star ``` button at the top of the repository.

<br><br>

## Disclaimer
This application is my own work and is not the result of plagiarism from other people's research or work, except those related to third party services which include: libraries, frameworks, and so on.

<br><br>

## LICENSE
MIT License - Copyright © 2022 - Devan C. M. Wijaya, S.Kom

Permission is hereby granted without charge to any person obtaining a copy of this software and the software-related documentation files to deal in them without restriction, including without limitation the right to use, copy, modify, merge, publish, distribute, sublicense, and/or sell copies of the Software, and to permit persons receiving the Software to be furnished therewith on the following terms:

The above copyright notice and this permission notice must accompany all copies or substantial portions of the Software.

IN ANY EVENT, THE AUTHOR OR COPYRIGHT HOLDER HEREIN RETAINS FULL OWNERSHIP RIGHTS. THE SOFTWARE IS PROVIDED AS IS, WITHOUT WARRANTY OF ANY KIND, EITHER EXPRESS OR IMPLIED, THEREFORE IF ANY DAMAGE, LOSS, OR OTHERWISE ARISES FROM THE USE OR OTHER DEALINGS IN THE SOFTWARE, THE AUTHOR OR COPYRIGHT HOLDER SHALL NOT BE LIABLE, AS THE USE OF THE SOFTWARE IS NOT COMPELLED AT ALL, SO THE RISK IS YOUR OWN.
